el-pths/theremin-ok/aux/sonar-pcb.gif

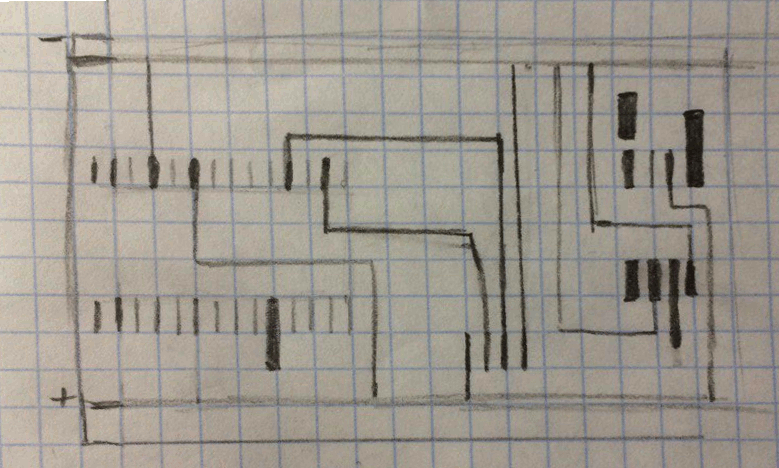
aux/sonar-pcb.gif
