el-pths/theremin-ok/aux/blind-sonar-proto.jpg

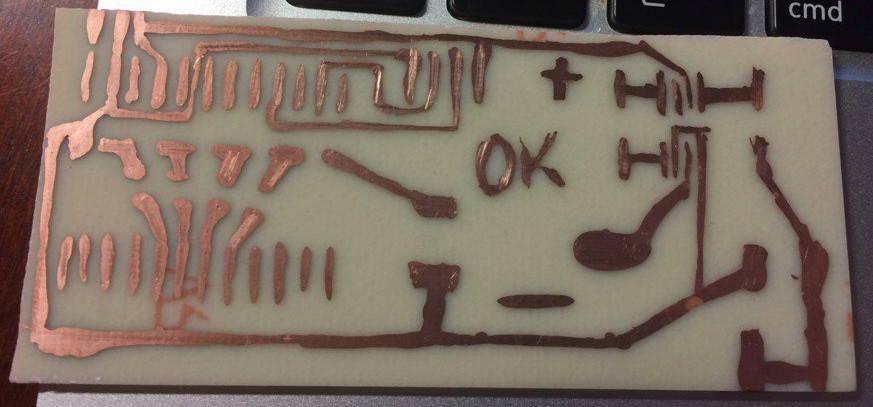
aux/blind-sonar-proto.jpg
