el-pths/theremin-ok/README.md

#Цифровой Терменвокс

**Цель работы:** создание электронного музыкального инструмента, генерирующего звук, высота которого изменяется в зависимости от расстояния до ладони музыканта. Проект выполняется на базе микроконтроллерного модуля Arduino, датчика расстояния и самодельного аналогового модуля для вывода звука (ЦАП + усилитель).

**Этапы работы:**
- подготовка формы сигнала для генератора звука;
- выбор датчика расстояния;
- подключение, изучение и тестирование датчика расстояния;
- реализация генератора звука по заданной форме сигнала;
- проектирование ЦАП для вывода звука;
- управление генератором звука с помощью датчика расстояния;
- линеаризация управляющей зависимости;
- опционально - реализация управления громкостью с помощью второго датчика;
- разработка печатной платы;
- монтаж и тестирование.

**Список заданий:** https://github.com/el-pths/theremin-ok/issues
