el-pths/theremin-ok/aux/README.md

В этой папке вспомогательные файлы, документация и т.п.
