el-pths/theremin-ok/aux/dac-sine.png

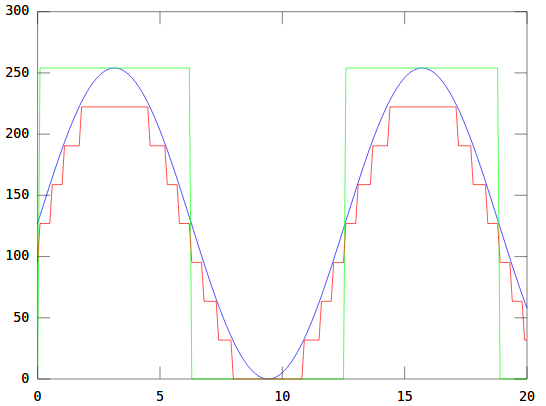
aux/dac-sine.png
