el-pths/theremin-ok/aux/lm386-sch.png

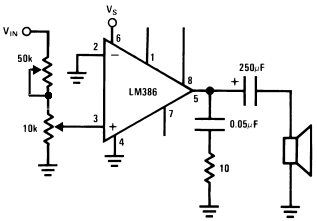
aux/lm386-sch.png
