el-pths/theremin-ok/aux/r2r-ladder.png

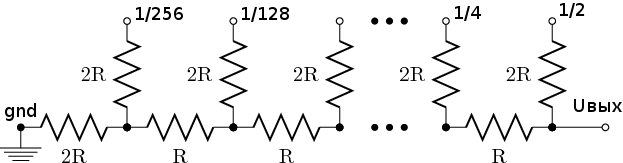
aux/r2r-ladder.png
