el-pths/theremin-ok/aux/sonar-mega-sch.png

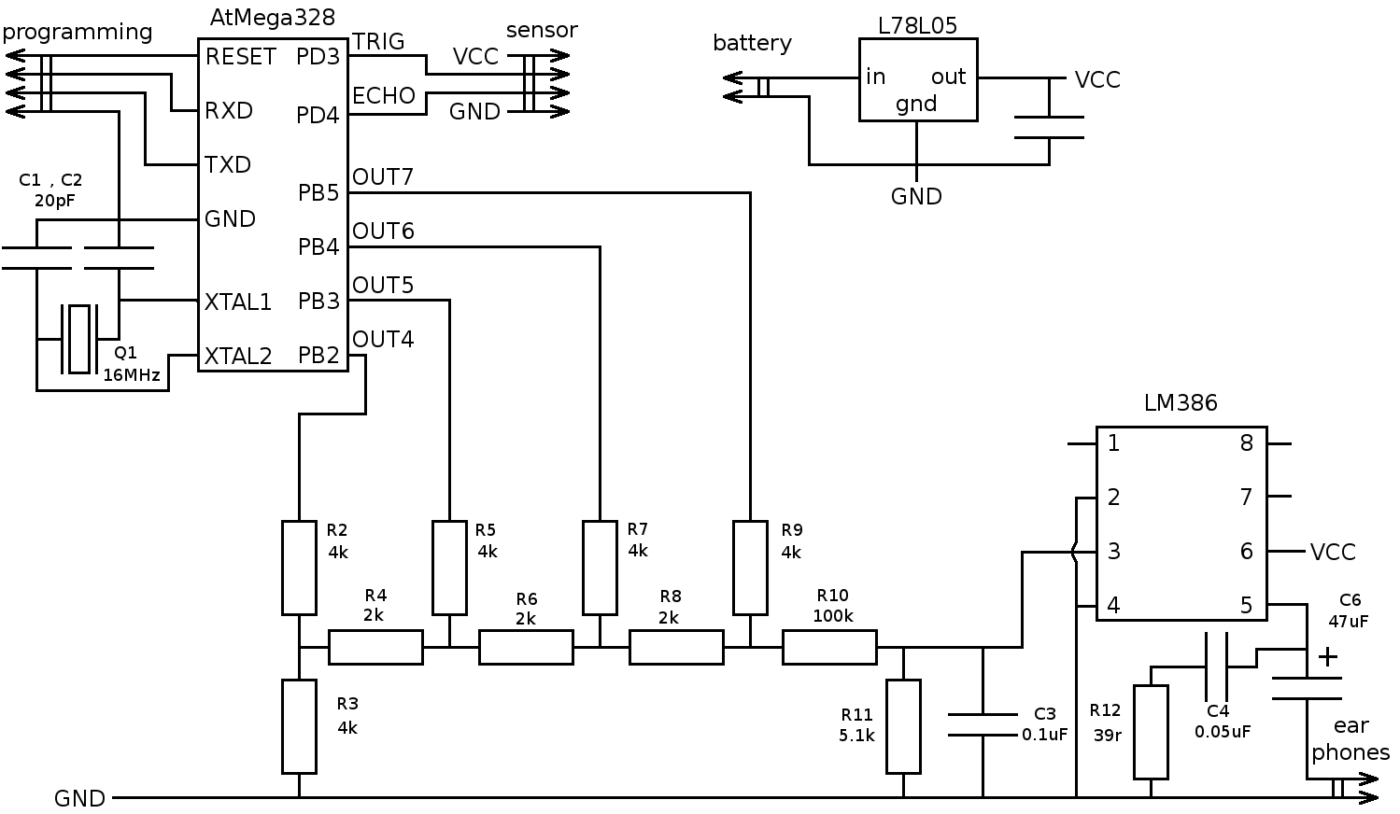
aux/sonar-mega-sch.png
