el-pths/theremin-ok/aux/sonar-sch.png

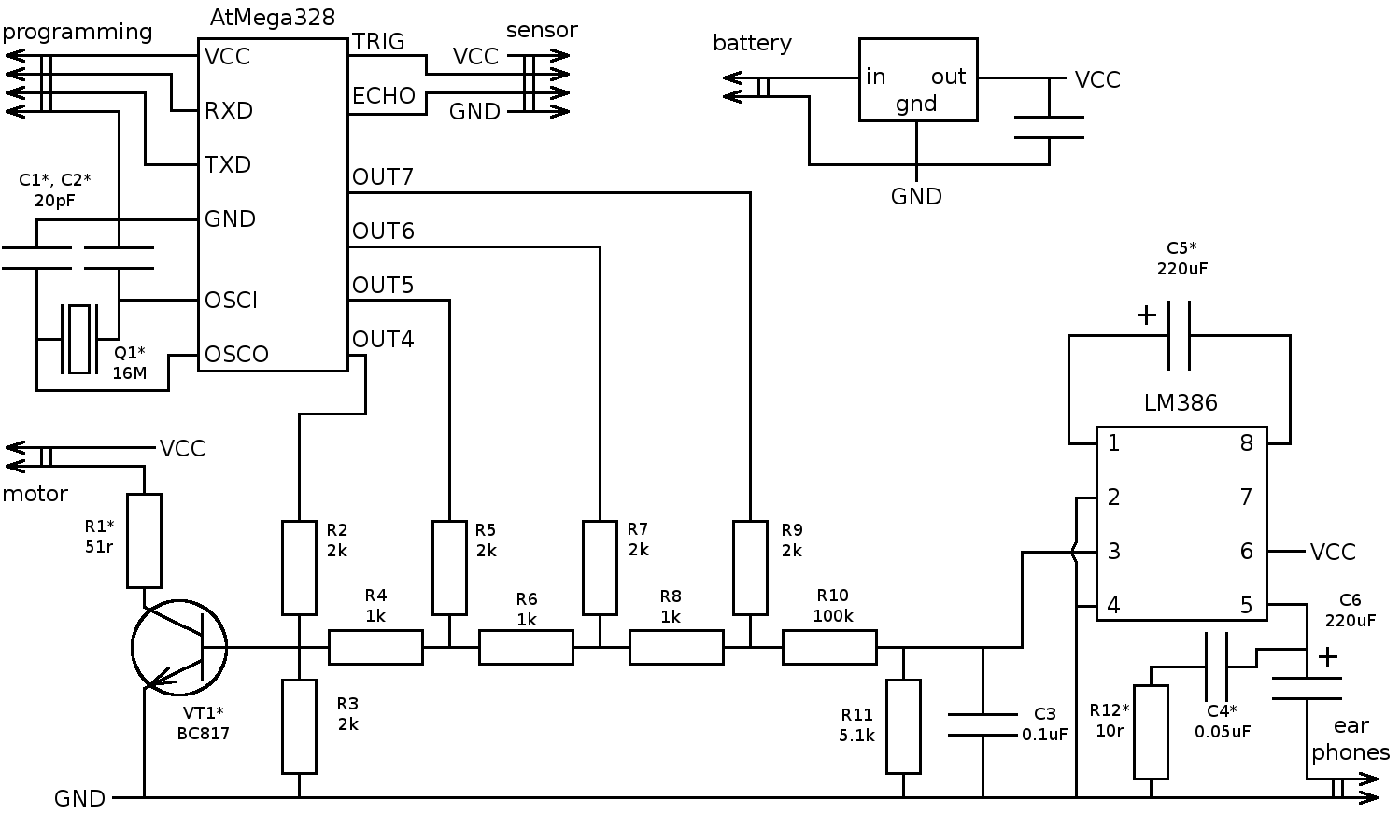
aux/sonar-sch.png
