el-pths/theremin-ok/aux/sonar-tiny-sch.png

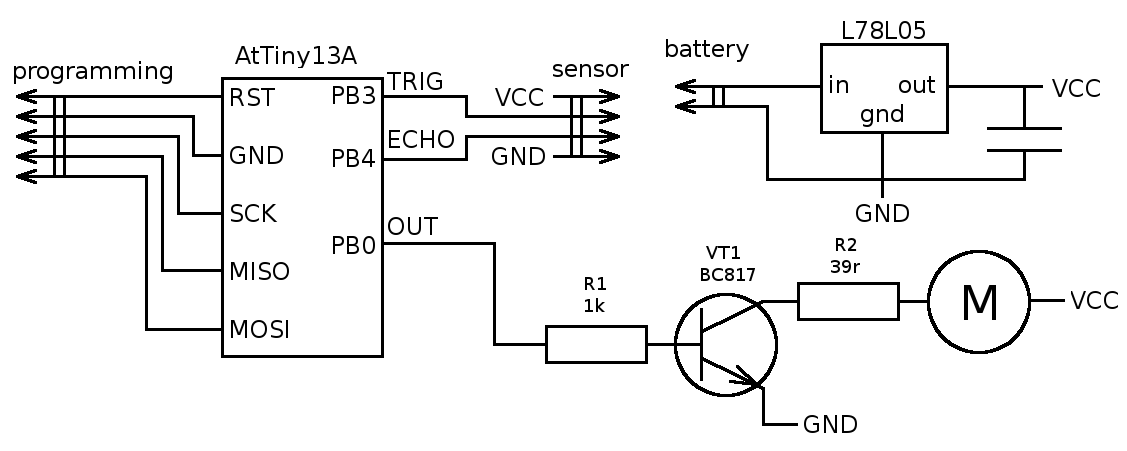
aux/sonar-tiny-sch.png
