el-pths/theremin-ok/(threads)

Thread 1 (2016-09-08):

Прекалькуляция синусоиды для генератора звука

RodionGork, 2016-09-08:
Цифровой Терменвокс издает звуки, подавая (через специальный преобразователь) заданное напряжение на присоединенный динамик. Напряжение будет задаваться числом в диапазоне от 0 до 255. (число 255 соответствует максимальному напряжению в 5 вольт)

Если просто выдать число 255, то из динамика мы услышим щелчок и больше ничего. Для того чтобы был слышен какой-то постоянный звук, нужно выдавать на динамик изменяющиеся значения, т.е. колебания с некоторой частотой.

Для начала хочется выдавать хотя бы простую синусоиду. Для этого мы заведем массив из `N = 512` значений и заполним его одним периодом синуса. Здесь следует учесть что:

- `sin(x)` изменяется от -1 до +1, а нам нужно от 0 до 255, надо как-то "поправить" выходной диапазон значений;
- у `sin(x)` период примерно 6.28, а мы хотим 512, т.е. надо синусоиду растянуть еще и в длину
- результирующие значения должны быть целыми (можно округлить их вниз).

Т.е. требуется сочинить программу которая напечатает 512 значений примерно так:

    127
    131
    135
    ....
    255
    ....
    128
    124
    ....
    0
    ...
    120
    124

А еще лучше если программа будет уметь печатать их в формате соответствующем синтаксису массива в языке java или Си:

    [127,131, ... ,255, ... ,128,124, ... ,0, ... ,120,124]

Тогда их можно будет впоследствии прямо скопировать из результата и вставить в текст программы для микроконтроллера.

Thread 2 (2016-09-08):

Установка Arduino IDE (опционально)

RodionGork, 2016-09-08:
Для Терменвокса попробуем использовать программируемый чип от фирмы Atmel. Для удобства работы существует некая платформа Arduino позволяющая писать для таких чипов программы на языке похожем на простой вариант С или Java.

Надо проверить удастся ли справиться с установкой среды разработки, в которой пишутся программы и с помощью которой они заливаются в чип (когда он будет).

качать нужно отсюда:
https://www.arduino.cc/en/Main/Software

здесь вроде есть инструкция:
https://www.arduino.cc/en/Guide/Windows

Которые увы на английском. Но если нужно наверное на русском тоже можно найти "установка Arduino IDE" или как-то так.

Если удастся ее запустить, из меню находим пример проекта "Examples / Blink" или как-то так. Нужно ее открыть и нажать кнопку (кажется, под главным меню) Verify - чтобы проверить что код компилируется. Загружать его никуда не надо поскольку пока нет платы с чипом, загружать его и некуда.

Все это вкратце соответствует началу этой инструкции:
https://github.com/el-pths/w/wiki/arduino-start

Если все получится, я подготовлю контроллер и макетную плату с которыми дальше нужно будет работать с помощью этого продукта.

Thread 3 (2016-09-13):

Выбор датчика расстояния

RodionGork, 2016-09-13:
Терменвокс будет использовать какой-нибудь современный датчик расстояния для определения положения руки музыканта. Нужно выбрать датчик, подходящий по следующим соображениям:

- диапазон расстояний - для терменвокса характерные расстояния например от 5 до 100 сантиметров;
- принцип работы - лазерные, ультразвуковые, оптические, емкостные - скорее всего подходит не все;
- компактный размер и масса (датчики весом больше 100 граммов считаем неподходящими);
- цена - предпочтительно не более 500 рублей.

Предположительно стоит посмотреть сайты магазинов http://www.chipdip.ru/ и http://roboparts.ru/ (возможно там придется поискать нужный раздел)

RodionGork, 2016-09-23:
http://roboparts.ru/products/hc-sr04 или http://roboparts.ru/products/us-015

Thread 4 (2016-09-18):

Подключение к датчику расстояния

RodionGork, 2016-09-18:
После того как датчик выбранный в #3 будет доступен, написать программу для контроллера, осуществляющую измерение и выводящую результат через последовательный порт, так чтобы можно было убедиться в работоспособности датчика и оценить его точность.

OlesiaAAA, 2016-10-11:
Так, ну, на вход приходит логическая единица, потом, я так понимаю, он высылает вперед 8 звуковых импульсов, а затем, обработав вернувшиеся импульсы, выводит единицу на время, пропорциональное расстоянию.

RodionGork, 2016-10-11:
Суть отражена верно. Предлагаю продолжать!

OlesiaAAA, 2016-10-26:
Done!
https://github.com/el-pths/theremin-ok/blob/master/DistanceSensor.ino

RodionGork, 2016-10-26:
Much better, thanks!

Thread 5 (2016-09-24):

Генерация звука

RodionGork, 2016-09-24:
Мы умеем выводить звук, подключив динамик к одному из выводов контроллера и потом меняя уровень на этом выводе с некоторыми задержками:

    void loop() {
        digitalWrite(15, HIGH);
        delay(2);
        digitalWrite(15, LOW);
        delay(2);
    }

Однако при таком способе для изменения частоты нужно менять задержки. Выводить звук какой-то сложной формы (в будущем) таким способом слишком сложно.

Попробуем сделать по-другому. Пусть контроллер выставляет напряжение на динамик всегда с одной частотой. А изменять мы будем функцию, по которой это напряжение меняется от раза к разу.

**Рассмотрим пример:** мы хотим чтобы напряжение на динамике выставлялось 8000 раз в секунду (такая частота используется во всей цифровой телефонии). Это значит, что в цикле нам нужно будет выставлять новое значение и потом делать паузу на 125 микросекунд.

    void loop() {
        digitalWrite(15, ...); // откуда возьмем это значение?
        delayMicroseconds(125);
    }

В задаче #1 был подготовлен массив значений синусоиды. Вставим его в новую программу и будем выдавать на динамик каждый раз следующее значение из этого массива. Для этого нам придется завести глобальную переменную хранящую текущую позицию в массиве с синусоидой и каждый раз ее увеличивать:

    byte sineValue[] = {...}; // наша синусоида
    int pos = 0;
    void loop() {
        byte sineValue = sine[pos];
        pos++; // здесь мы можем регулировать скорость изменения!
        // здесь еще надо проверить, если pos вышел за массив, надо его вернуть в начало
        digitalWrite(15, ...); // HIGH или LOW в зависимости от sineValue
        delayMicroseconds(125);
    }

Остался вопрос - как нам выбирать HIGH или LOW в зависимости от текущего значения нашей синусоиды. Поскольку значения в массиве от 0 до 255, предлагается выставлять HIGH если значение больше 127 - или LOW в противном случае. (в дальнейшем мы будем выводить несколько бит этого значения сразу на несколько ног контроллера чтобы изменять напряжение более деликатно, но пока хватит и этого)

TolikAnishenko, 2016-09-24:
Интересненько)))

RodionGork, 2016-09-29:
С этой строки начиная:

https://github.com/el-pths/theremin-ok/blob/master/Djnn.ino#L16

Заменить следующие 2 условных блока одним тернарным оператором.

Переименовать файл, например, в `WaveGenerator.ino`.

Отписаться в комментарии к этому заданию и мы его пометим закрытым.

OlesiaAAA, 2016-10-11:
Ну, вроде вот. Теперь там одно ино в конце

RodionGork, 2016-10-11:
И впрямь вроде вот, молодец!
Тогда старую копию (Djnn) я пойду удалю.

Thread 6 (2016-10-14):

Прототип датчика препятствий

RodionGork, 2016-10-14:
В ходе #4 мы должны научиться работать с датчиком расстояния. После этого уместно на время переключиться на практическую работу, чтобы собрать воедино полученные навыки.

Предлагается в качестве промежуточного этапа создать прибор, позволяющий ориентироваться в пространстве, например, инвалидам по зрению. Также его можно будет использовать для интерактивных игровых мероприятий.

В общих чертах это представляется так:

- на человека надеваются наушники, с закрепленным на них прибором
- прибор периодически (например, раз в секунду) зондирует пространство впереди с помощью УЗ-датчика - и определяет расстояние до ближайшего препятствия
- на наушники выводится какой-либо сигнал, как-то коррелирующий с определенным расстоянием...

**Задача**

- Детализировать вышеприведенное описание (придумать формат сигнала, характерные расстояния и т.п.)
- Запрограммировать на макетной плате, проверить
- Перечислить что требуется для создания автономного прототипа (реального девайса который можно было бы носить хотя бы для тестирования в лаборатории)

Thread 7 (2016-10-23):

Схема и Плата для прототипа

RodionGork, 2016-10-23:
Изготовим плату которую можно использовать в прототипе. Универсальную в том смысле, что ее можно использовать для сонара или терменвокса (в зависимости от прошитой программы). В ней должны присутствовать:

- разъем подключения датчика (4-контактный)
- разъем для подсоединения платы Arduino Micro (два ряда по 15 контактов) - отдельный контроллер мы будем проектировать позже, в плате для готового устройства, не прототипа
- цифро-аналоговый-преобразователь на резисторах подключенный к нескольким выходам контроллера, для выдачи звукового сигнала
- усилительный каскад на LM386 между АЦП и аудиовыходом
- гнездо для наушников (3.5 мм) для аудиовыхода
- гнездо или клеммы для подключения питания, также, возможно, место для стабилизатора питания.

(продолжение следует)

RodionGork, 2016-12-07:
Эскиз возможной трассировки от Олеси

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

Немного подумав я предлагаю перенести разъем датчика на другую сторону и слегка изменить дизайн как показано на следующей анимации. Это позволит сделать плату уже.

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

Т.е. нужно предусмотреть следующее:

- переменный резистор будет припаиваться на плату
- звуковой сигнал идет не прямо с пятой ноги, а через резистивный ЦАП с ног 2-3-4-5 (впаяв вместо него перемычку мы получим то же самое).
- микросхема LM386 будет в корпусе SO-8 вместо DIP-8 (в два раза меньше)
- на плате будет также гнездо наушников
- и разъем для подключения питания + регулятор на 5 Вольт (переносную конструкцию питать будем от 9В батарейки, наверное).

RodionGork, 2017-02-04:
рабочий вариант:

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

Thread 8 (2016-10-23):

Программу генерации звука модифицировать для работы с АЦП

RodionGork, 2016-10-23:
В программе [WaveGenerator](https://github.com/el-pths/theremin-ok/blob/master/WaveGenerator.ino) мы выводим звук по форме волны записанной в массиве. Однако пока вывод работает только на одну ногу и зависит только от старшего разряда текущего значения массива:

    digitalWrite(15, (sineValue > 127) ? HIGH : LOW);

Нужно сделать чтобы он работал на несколько ног (допустим, 5,4,3,2) и выводил на них соответствующее количество старших разрядов.

То есть, например, если текущее значение из массива равно `213` то в двоичном виде оно представляется как `11011101`. Мы хотим первые (старшие) 4 разряда этого числа вывести на ноги контроллера, т.е. `5 = HIGH, 4 = HIGH, 3 = LOW, 2 = HIGH`.

Это позволит нам подключить к выводам контроллера соответствующее количество резисторов с разным сопротивлением, например:

- к 5 ноге - 1 кОм
- к 4 ноге - 2 кОм
- к 3 ноге - 4 кОм
- к 2 ноге - 8 кОм

И сделать из них резистивный аналого-цифровой преобразователь (АЦП), позволяющий иметь 16 разных уровней напряжения. В результате мы сможем иметь гораздо более приятный звук на наушниках / динамике - и кроме того он будет довольно точно воспроизводить запрограммированную форму волны.

RodionGork, 2017-02-04:
Существует также способ изменить состояние подключенных к ЦАП ног "одним махом". Дело в том, что ноги контроллера объединены по 8 штук и управляются несколькими "магическими" переменными. В частности переменная с названием `PORTD` позволяет вывести 8-битовое число (типа byte) на 8 ног с 0-й по 7-ю.

_Такие "магические" переменные называются "регистрами специального назначения" - на самом деле вся работа с аппаратными возможностями контроллера происходит через подобные регистры, просто от программиста Arduino это обычно скрыто._

Таким образом, если мы напишем и выполним выражение в духе:

    PORTD = 0b00110100;
    // или в 16-ричном виде
    PORTD = 0x3B;
    // или в 10-чном виде
    PORTD = 59;

то мы выставим высокий уровень (HIGH) на ногах 5, 4, 2 а на остальных низкий (LOW). Младший разряд числа соответствует ноге номер 0, а старший ноге номер 7:

    ноги:  7 6 5 4 3 2 1 0
    ----------------------
    0 b    0 0 1 1 0 1 0 0

Как нам это использовать в программе, с учетом того что ЦАП подключен к ногам 5-2? У нас всего 4 ноги, поэтому 8-разрядное число мы вывести целиком не сможем. Будем использовать только самые старшие разряды, и притом сдвинем их на 2 позиции вправо (т.е. 7-й разряд выйдет на 5-ю ногу, а 4-й на 2-ю).

Создадим функцию например `outputValue` и спрячем подробности внутри нее:

    void outputValue(byte value) {
      // сдвинуть value на 2 позиции вправо операцией >>
      // записать полученное значение в PORTD
    }

Теперь эту функцию можно использовать для вывода синусоиды. Однако сперва было бы полезно написать маленькую отдельную программу для тестирования ЦАП. Пусть она выводит числа от 0 до 255 по возрастанию (с небольшой задержкой) - а мы подключим на выход вольтметр и будем следить как нарастает напряжение.

Thread 9 (2016-10-30):

Цифро-Аналоговый Преобразователь - R-2R цепочка

RodionGork, 2016-10-30:
Это задание является частью #7. Ниже описывается его схема, которая должна стать частью общей схемы устройства. Когда прототип или макет с ЦАП будет готов, необходимо также написать небольшую программу для проверки работы ЦАП. Она должна подавать на выход последовательно увеличивающиеся числа, с определенной задержкой - так что рост напряжения на выходе можно будет контролировать подключенным светодиодом или лучше вольтметром.

**Что такое ЦАП**

Сначала мы выводили звук на динамик подключенный к единственной ноге контроллера. Следовательно, напряжение на динамике не может изменяться плавно, а только скачками от высокого к низкому и обратно. Поэтому попытка выводить синусоиду на самом деле приводит к прямоугольным колебаниям.

Для слуха они звучат как нота той же частоты, но с неприятным, режущим акцентом. Для того чтобы воспроизводить звук более точно, мы построим Цифро-Аналоговый-Преобразователь. Суть его работы в том, что к нескольким (например, от 4 до 8) ногам контроллера будет подключена резистивная схема, обладающая таким свойством, что напряжение на ее выходе пропорционально двоичному числу на этих ногах.

Следующий рисунок поясняет идею. Здесь синяя линяя представляет идеальную синусоидальную волну, как мы бы хотели ее получить. Зеленая - то что мы получаем используя для вывода звука единственный выход контроллера - прямоугольные колебания. Красная - колебания полученные с помощью 3-разрядного ЦАП (т.е. с 3-х выходов контроллера).

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

**ЦАП в виде R-2R-цепочки**

Популярная схема ЦАП состоит из двух наборов резисторов, различающихся по сопротивлению в 2 раза.

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

Сверху этой схемы изображены входы, подключаемые к ногам контроллера. Они отмечены дробями, показывающими какой "вклад" каждый вход дает в выходное напряжение. Отсюда видно что крайняя левая нога - самый младший разряд. Крайняя правая - самый старший. Например если на двух самых правых входах будет +5 В, а на остальных 0 В, то напряжение на выходе составит около (1/2 + 1/4) * 5 В = 3.75 В

На данном рисунке предполагается что всего подключено 8 ног. В принципе можно ограничиться и меньшим количеством, например 6-ю. Резисторы можно взять например 1 кОм и 2 кОм - тогда и от контроллера будет уходить через ноги не слишком большой ток - и выход получится не слишком "слабым" по току.

**Задание** После того как плата с таким ЦАП будет спроектирована и изготовлена - написать программу и протестировать работу ЦАП.

Thread 10 (2016-10-31):

Усилитель на LM386

RodionGork, 2016-10-31:
Как подключить наушники или небольшой динамик (пассивную колонку) к контроллеру?

Напрямую подсоединить нельзя. Контроллер выдает напряжение 5В, но максимальный ток через любую ногу не должен превышать 20 мА. В то же время сопротивление наушников около 50 Ом, а динамика 8 Ом или меньше - что вызовет ток равный:

    Iнауш  =  U / R  =  5  /  50  =  0.1 A    (100мА)
    Iдин  = 5 / 8  =  0.625 A    (625мА)

К тому же такой большой ток вызовет слишком громкие звуки и, вероятно, может повредить наушники / динамик.

Для сопряжения нужен усилительный каскад, который на выходе может выдавать небольшие напряжения но мощные токи. К счастью нам не придется изобретать его с нуля, т.к. существует популярная микросхема LM386 в корпусе с 8 ногами (DIP-8 или поменьше SOIC-8).

Руководство к ней можно найти с помощью запроса "LM386 PDF". Здесь кроме примерного внутреннего устройства и основных характеристик приведены также возможные схемы подключения (раздел Typical Applications). Возьмем первую, наиболее простую из них:

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

Минус питания подключается ко всем контактам отмеченным символом заземления (GND). Плюс к контакту Vs (сверху).

Выход, представленный здесь динамиком, нужно выполнить в виде разъема под наушники (стандартный джек диаметром 3.5 мм).

Вход (с ЦАП) приходит на регулятор громкости, представленный делителем напряжения из двух резисторов. Нижний по схеме резистор - переменный, с какой-нибудь готовой ручкой или колесиком для вращения - верхний можно взять подстроечным (который поворачивается отверткой) - он нужен для грубой регулировки, например, при переключении с наушников на колонки.

**Задача** состоит в том чтобы выбрать недостающие компоненты и добавить часть с усилителем в общую схему в задании #7.

Thread 11 (2017-02-08):

Упростить сигналы для сонара

RodionGork, 2017-02-08:
В прототипе сонара используются сигнализация расстояния звуком следующим образом: мы создали массив из частот для 20 разных нот (отличающихся на полтона) и выбираем из него нужную частоту пропорционально расстоянию. Например, на 30 сантиметрах издаем сигнал нотой До, на 60 нотой До-диез, на 90 нотой Ре и так далее.

Однако для практических целей, а так же для носителей не имеющих деликатного музыкального слуха, наверное следует упростить систему и сделать сигналы более выраженными.

Например так:

- если препятствие обнаружено на расстоянии более 3 метров, издается один низкий звук, например нота "до"
- если расстояние от 2 до 3 метров - два коротких низких звука, "до-до"
- если от 1 до 2 метров - высокий звук, например "ля"
- если меньше 1 метра - два коротких, низкий и высокий, например "до" и "ля-бемоль" - это звучит тревожно

Thread 12 (2017-04-09):

Окончательная плата сонара

RodionGork, 2017-04-09:
Окончательная схема не будет содержать готовой платы Arduino. Вместо этого используем микроконтроллер AtMega328 (являющийся сердцем Arduino) и минимум дополнительных компонент.

Требуется создать разводку платы с учетом использования такого контроллера. Для этого:

1. Найти схему платы Arduino Mini (запросом "arduino mini schematics") и изучить ее для того, чтобы понять как номерные выводы Ардуино (D2, D3... D12 и т.п.) соответствуют собственным ногам контроллера (PA0, PA1..., PB0... PC8)

2. Найти руководство к AtMega328 (запросом "atmega328 datasheet") - его прокрутить до изображений с расположением выводов на корпусах разных типов (где-то в пределах первых 20-30 страниц) - выбрать корпус TQFP с 32 выводами.

3. Нарисовать эскиз (карандаш, бумага в клеточку) размещения компонент, разъемов и их соединений согласно схеме ниже.

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
