el-pths/theremin-ok/ForBlind.ino

#define NOT 20

byte sineValue[] = {127, 128, 130, 132, 133, 135, 136, 138, 139, 141, 142, 144, 146, 147, 149, 150, 152, 153, 155, 156, 158, 159, 161, 162, 164, 165, 167, 168, 170, 171, 173, 174, 176, 177, 179, 180, 182, 183, 184, 186, 187, 188, 190, 191, 193, 194, 195, 197, 198, 199, 200, 202, 203, 204, 206, 207, 208, 209, 210, 212, 213, 214, 215, 216, 217, 218, 219, 221, 222, 223, 224, 225, 226, 227, 228, 229, 230, 230, 231, 232, 233, 234, 235, 236, 236, 237, 238, 239, 240, 240, 241, 242, 242, 243, 244, 244, 245, 245, 246, 247, 247, 248, 248, 249, 249, 250, 250, 250, 251, 251, 251, 252, 252, 252, 253, 253, 253, 253, 254, 254, 254, 254, 254, 254, 254, 254, 254, 254, 254, 254, 254, 254, 254, 254, 254, 254, 254, 254, 253, 253, 253, 253, 253, 252, 252, 252, 251, 251, 251, 250, 250, 249, 249, 248, 248, 247, 247, 246, 246, 245, 245, 244, 243, 243, 242, 241, 241, 240, 239, 238, 238, 237, 236, 235, 234, 234, 233, 232, 231, 230, 229, 228, 227, 226, 225, 224, 223, 222, 221, 220, 219, 218, 217, 216, 214, 213, 212, 211, 210, 208, 207, 206, 205, 204, 202, 201, 200, 198, 197, 196, 195, 193, 192, 190, 189, 188, 186, 185, 184, 182, 181, 179, 178, 176, 175, 174, 172, 171, 169, 168, 166, 165, 163, 162, 160, 159, 157, 156, 154, 152, 151, 149, 148, 146, 145, 143, 142, 140, 138, 137, 135, 134, 132, 131, 129, 128, 126, 124, 123, 121, 120, 118, 117, 115, 113, 112, 110, 109, 107, 106, 104, 103, 101, 99, 98, 96, 95, 93, 92, 90, 89, 87, 86, 84, 83, 81, 80, 79, 77, 76, 74, 73, 71, 70, 69, 67, 66, 64, 63, 62, 60, 59, 58, 56, 55, 54, 53, 51, 50, 49, 48, 46, 45, 44, 43, 42, 40, 39, 38, 37, 36, 35, 34, 33, 32, 31, 30, 29, 28, 27, 26, 25, 24, 23, 22, 21, 20, 19, 19, 18, 17, 16, 15, 15, 14, 13, 12, 12, 11, 10, 10, 9, 9, 8, 8, 7, 6, 6, 5, 5, 5, 4, 4, 3, 3, 3, 2, 2, 2, 1, 1, 1, 1, 0, 0, 0, 0, 0, 0, 0, 0, 0, 0, 0, 0, 0, 0, 0, 0, 0, 0, 0, 0, 0, 1, 1, 1, 1, 2, 2, 2, 3, 3, 3, 4, 4, 5, 5, 6, 6, 7, 7, 8, 8, 9, 9, 10, 11, 11, 12, 13, 13, 14, 15, 15, 16, 17, 18, 19, 19, 20, 21, 22, 23, 24, 25, 26, 27, 28, 29, 30, 31, 32, 33, 34, 35, 36, 37, 38, 39, 41, 42, 43, 44, 45, 46, 48, 49, 50, 51, 53, 54, 55, 57, 58, 59, 61, 62, 63, 65, 66, 67, 69, 70, 72, 73, 74, 76, 77, 79, 80, 82, 83, 85, 86, 88, 89, 91, 92, 94, 95, 97, 98, 100, 101, 103, 104, 106, 107, 109, 110, 112, 114, 115, 117, 118, 120, 121, 123, 125, 126, 128};
int notes[NOT];
int sm, t1, t2;
void setup() {
  notes[NOT - 1] = 440;
  for (int i = NOT - 2; i >= 0; i--) {
    notes[i] = (int) (notes[i + 1]*1.059);
  }
  pinMode(15, OUTPUT);
  pinMode(16, INPUT_PULLUP);
  pinMode(5, OUTPUT);
}

void loop() {
 digitalWrite(15, HIGH);
 delayMicroseconds(10);
 digitalWrite(15, LOW);
 while(digitalRead(16) == LOW){
  t1 = micros();
 }
 while(digitalRead(16) == HIGH){
  t2 = micros();
  }
 sm = (t2 - t1)/58;
 int nota = sm/10;
 if(nota < NOT){
  makesound(100, notes[nota]);
 }
 delay(sm < 100 ? 300 : 700);
}

void makesound(int ms, int f){
 int pos = 0, incr = (f*512l*125)/1000000;
 for(int i = 0; i < 8 * ms; i++){
  byte sineValue1 = sineValue[pos];
  pos += incr;
  if(pos >= 512){
    pos = 0; 
  }
  digitalWrite(5, (sineValue1 > 127) ? HIGH : LOW);
  delayMicroseconds(125);
 }
}
