el-pths/theremin-ok/(commit log)

2016-09-29 Папка для дополнительной информации
2016-09-30 Signals for distance sensor
2016-10-20 Minor updates to program for distance sensor
2016-10-30 R-2R ladder schematics
2016-12-07 Drafts of pcb for sonar
2017-02-04 Sonar Prototype PCB ready
2017-04-09 Sonar schematics
2017-05-20 Schematics for last sonar prototypes
